hieun03/USB_CAN_Transceiver_Board/EasyEDA/3D_PCB_Bottom_View_2026-08-12.png

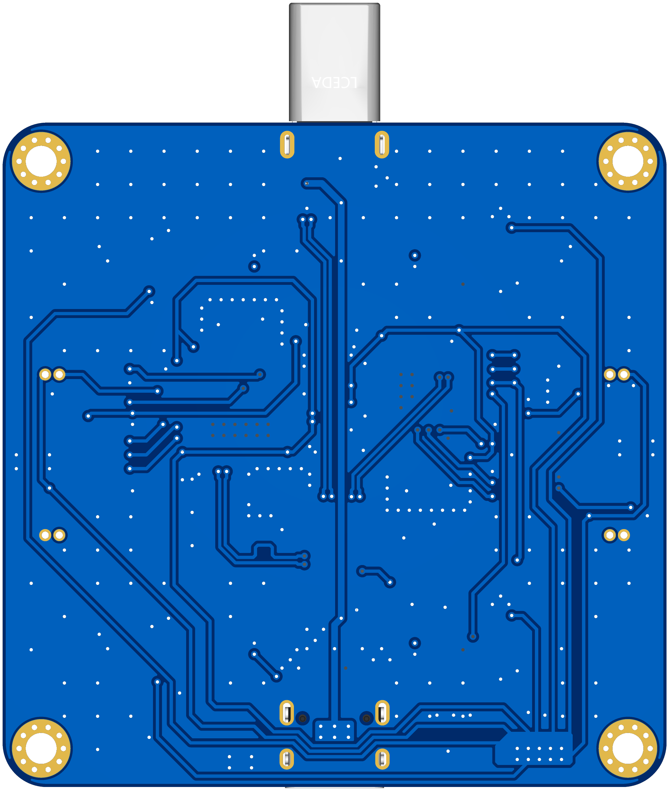
EasyEDA/3D_PCB_Bottom_View_2026-08-12.png
