hieun03/USB_CAN_Transceiver_Board/docs/CAN_FD_Adapter_Circuit_Schematic.xlsx

Sheet: MCU Pinout
CAN FD Adapter — MCU Pinout (STM32G474, single-channel / single USB port design)
Note: For the 2x USB + USB Hub architecture, this pin list applies to EACH MCU board separately (2 boards total).
Pin | Function | Connection | Alternate Function / Setting | Category | Note
PA11 | USB_DM | Hub downstream port D- | AF14 | USB | Internal USB FS PHY, no external IC needed
PA12 | USB_DP | Hub downstream port D+ | AF14 | USB | Internal USB FS PHY, no external IC needed
PB5 | FDCAN2_RX | CAN transceiver RXD | AF, Very High Speed | CAN | Single-channel use: FDCAN2 is sufficient
PB6 | FDCAN2_TX | CAN transceiver TXD | AF, Very High Speed | CAN | Single-channel use: FDCAN2 is sufficient
PB3 | FDCAN3_RX | CAN transceiver RXD (2nd channel) | AF, Very High Speed | CAN | Only if 2 channels are needed on the same MCU
PB4 | FDCAN3_TX | CAN transceiver TXD (2nd channel) | AF, Very High Speed | CAN | Only if 2 channels are needed on the same MCU
PH0 (OSC_IN) | HSE Input | 24 MHz crystal | - | Clock | External oscillator input
PH1 (OSC_OUT) | HSE Output | 24 MHz crystal | - | Clock | External oscillator output
NRST | Reset | Reset button + 100nF capacitor | - | Power/Reset | Standard reset circuit
BOOT0 | Boot Select | Pull-down 10kΩ | - | Boot | Optional jumper for entering DFU mode
SWDIO | Debug Data | Programming header | - | Debug | 4-pin header: SWDIO, SWCLK, GND, VDD
SWCLK | Debug Clock | Programming header | - | Debug | 4-pin header: SWDIO, SWCLK, GND, VDD
VDD (x4-6 pins) | Digital Power | 3.3V | - | Power | 100nF decoupling capacitor on each VDD pin
VSS (x4-6 pins) | Digital Ground | GND | - | Power | -
VDDA | Analog Power | 3.3V (filtered via ferrite bead) | - | Power | Clean power supply for ADC/PLL
VSSA | Analog Ground | GND | - | Power | -
VBAT | Backup Power | Can be bridged to 3.3V | - | Power | Bridge to VDD if RTC is not used

Sheet: CAN Transceiver IC
CAN Transceiver IC Options (one required per CAN channel)
Green row: recommended choice (cost/performance balance)
IC | Manufacturer | CAN FD Support | Max Speed | Approx. Unit Price (USD) | Package / Note
TCAN1042HGVDRQ1 | Texas Instruments | Yes | 5 Mbps | $1.20 - $1.80 | SOIC-8, automotive grade, widely used
TCAN1044VDRQ1 | Texas Instruments | Yes | 5 Mbps | $1.00 - $1.50 | SOIC-8, has standby mode, economical
MCP2562FD | Microchip | Yes | 8 Mbps | $1.00 - $1.40 | SOIC-8 / DFN, good price/performance
SN65HVD230 | Texas Instruments | No (classic CAN) | 1 Mbps | $0.60 - $0.90 | SOIC-8, does NOT support FD - DO NOT USE
ISO1042 | Texas Instruments | Yes | 5 Mbps | $3.00 - $4.50 | SOIC-8/16, galvanic isolation, for industrial environments
Note: Prices are estimates and vary by distributor (Mouser/DigiKey/LCSC) and quantity. Please verify current pricing.

Sheet: USB Hub IC
USB Hub IC Options (to combine 2 MCU boards into a single USB connector)
Architecture: PC <--USB--> [Hub IC] <--> 2x Downstream Port <--> 2x MCU Board (each manages its own CAN channel)
Green row: recommended choice
IC | Manufacturer | Port Count | Speed | Approx. Unit Price (USD) | Package / Note
FE1.1s | Terminus Technology | 4 ports | USB 2.0 HS/FS | $0.30 - $0.50 | SSOP-28, cheapest, no external EEPROM needed
GL850G | Genesys Logic | 4 ports | USB 2.0 HS/FS | $0.50 - $0.80 | SSOP-28, stable, widely used
USB2513B | Microchip | 3 ports | USB 2.0 HS/FS | $1.50 - $2.20 | QFN-36, industrial grade, SMBus config option
USB2517 | Microchip | 7 ports | USB 2.0 HS/FS | $2.00 - $3.00 | QFN-48, extra port capacity, good support
TUSB2077A | Texas Instruments | 7 ports | USB 2.0 FS | $1.50 - $2.00 | QFP-48, older but proven design

Sheet: Hub Additional Parts
Additional Components Required for the USB Hub IC
Component | Function | Qty | Note
12 MHz Crystal | Hub clock source | 1 | Required by most hub ICs (FE1.1s / GL850G)
Upstream Port (USB-B/USB-C) | Host (PC) connection | 1 | Single connector, facing the PC
Downstream Port | Connection to MCU boards | 2 | Panel-mount connector or board-to-board
USBLC6-2SC6 | ESD protection | 3 | Separate one for upstream + each downstream port
Self/Bus-powered strap resistor | Power mode selection | 1 | Set via a pull-up/pull-down resistor
3.3V/5V Regulator | Power for hub + MCUs | 1 | Hub typically needs 3.3V, stepped down from 5V USB VBUS

Sheet: Summary & Architecture
Project Summary: 2x USB + 1x USB Hub Architecture
Architecture Diagram (text form):
PC
│
│ USB (Upstream)
▼
[USB Hub IC: FE1.1s / GL850G]
│ │
│ Downstream 1 │ Downstream 2
▼ ▼
[MCU Board 1: STM32G474] [MCU Board 2: STM32G474]
│ │
▼ ▼
[CAN Transceiver 1] [CAN Transceiver 2]
│ │
▼ ▼
CAN Bus 1 (can0) CAN Bus 2 (can1)
Main Component List:
Component | Qty | Recommended Model | Approx. Unit Price (USD) | Total (USD) | Note
MCU (STM32G474) | 2 | STM32G474xx | $3.50 - $5.00 | $7.00 - $10.00 | 1 per board
CAN Transceiver | 2 | MCP2562FD / TCAN1044V | $1.00 - $1.50 | $2.00 - $3.00 | 1 per MCU board
USB Hub IC | 1 | FE1.1s / GL850G | $0.30 - $0.80 | $0.30 - $0.80 | Single hub, 2 of 4 ports used
24 MHz Crystal (MCU) | 2 | - | $0.10 - $0.20 | $0.20 - $0.40 | 1 per MCU
12 MHz Crystal (Hub) | 1 | - | $0.10 - $0.15 | $0.10 - $0.15 | For the hub
ESD Protection (USBLC6-2SC6) | 3+ | - | $0.10 - $0.20 | $0.30 - $0.60 | Upstream + 2 downstream
Regulator (3.3V/5V) | 1-3 | - | $0.30 - $0.60 | $0.30 - $1.80 | Centralized or per-board
ESTIMATED TOTAL COST (ICs and passive components listed only, excluding PCB/connectors/enclosure): |  |  |  | ≈ $10.20 - $16.75
