hieun03/USB_CAN_Transceiver_Board/EasyEDA/SCH_Schematic_2026-08-12.pdf

Schematic | Schematic | Create at | 2026-07-25
Update at | 2026-08-11
Board | Board_1_0 | Page | Version
Drawn | Hieu N. | USB_CAN_Transceiver_Board
Reviewed | Yigitler A.
Version | Size | Page 1 Total 8
V0.0 | A4 | VNX Robotics
Date | Version Number | Details
July 25th 2026 | V1.0 | Finished on August 11th 2026

# 2 x CAN Transceiver

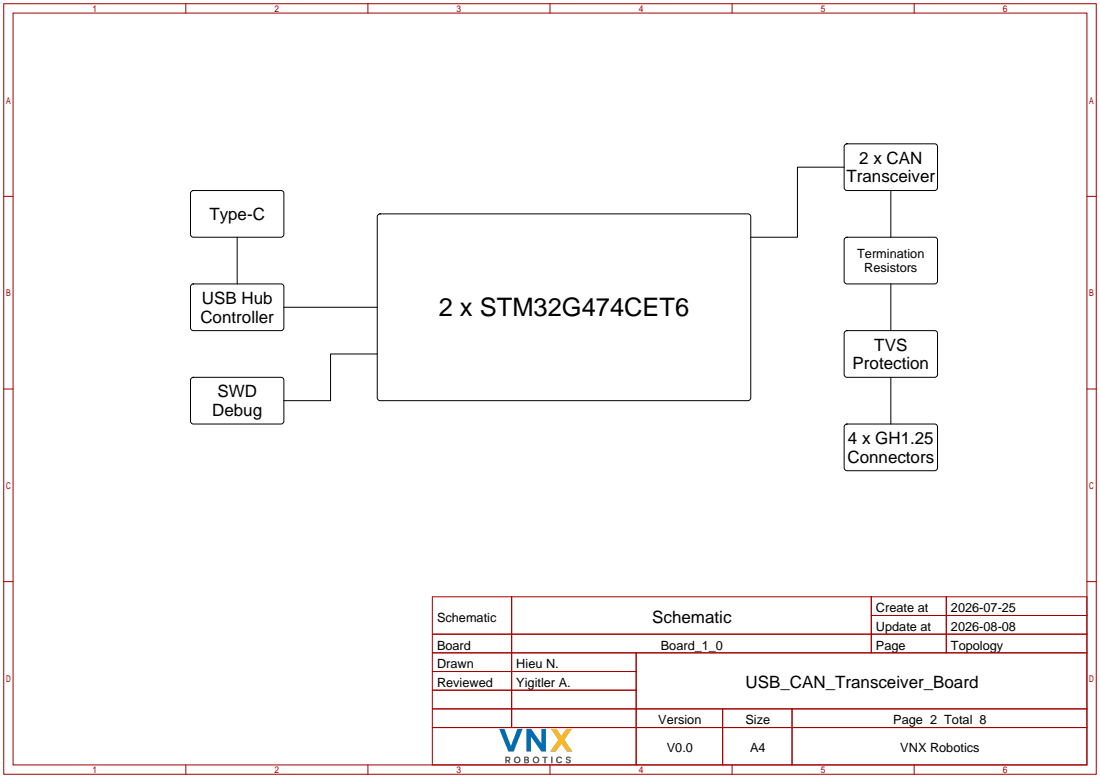
[picture p3: page 2]

Schematic | Schematic | Create at | 2026-07-25

Update at | 2026-08-08

Board | Board_1_0 | Page | Topology
Drawn | Hieu N. | USB_CAN_Transceiver_Board
Reviewed | Yigitler A.

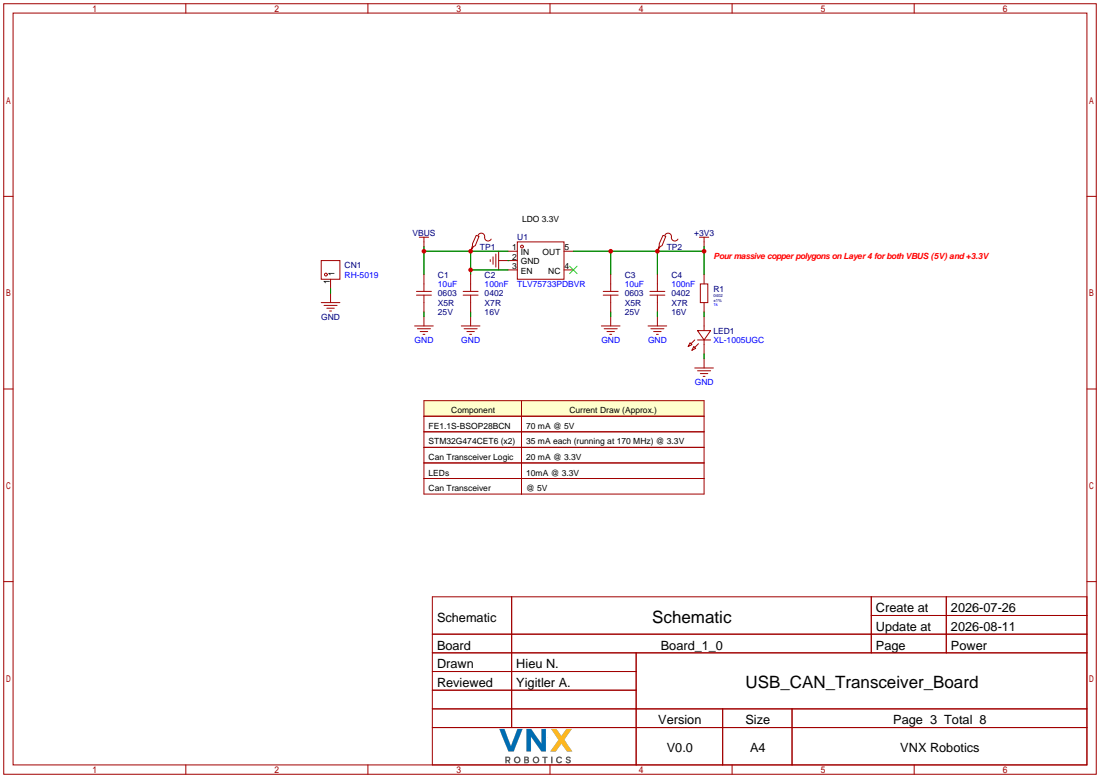
[picture p4: page 3]

Pour massive copper polygons on Layer 4 for both VBUS (5V) and +3.3V

Component | Current Draw (Approx.)
FE1.1S-BSOP28BCN | 70 mA @ 5V
STM32G474CET6 (x2) | 35 mA each (running at 170 MHz) @ 3.3V
Can Transceiver Logic | 20 mA @ 3.3V
LEDs | 10mA @ 3.3V
Can Transceiver | @ 5V

Schematic | Schematic | Create at | 2026-07-26

Update at | 2026-08-11

Board | Board_1_0 | Page | Power
Drawn | Hieu N. | USB_CAN_Transceiver_Board
Reviewed | Yigitler A.

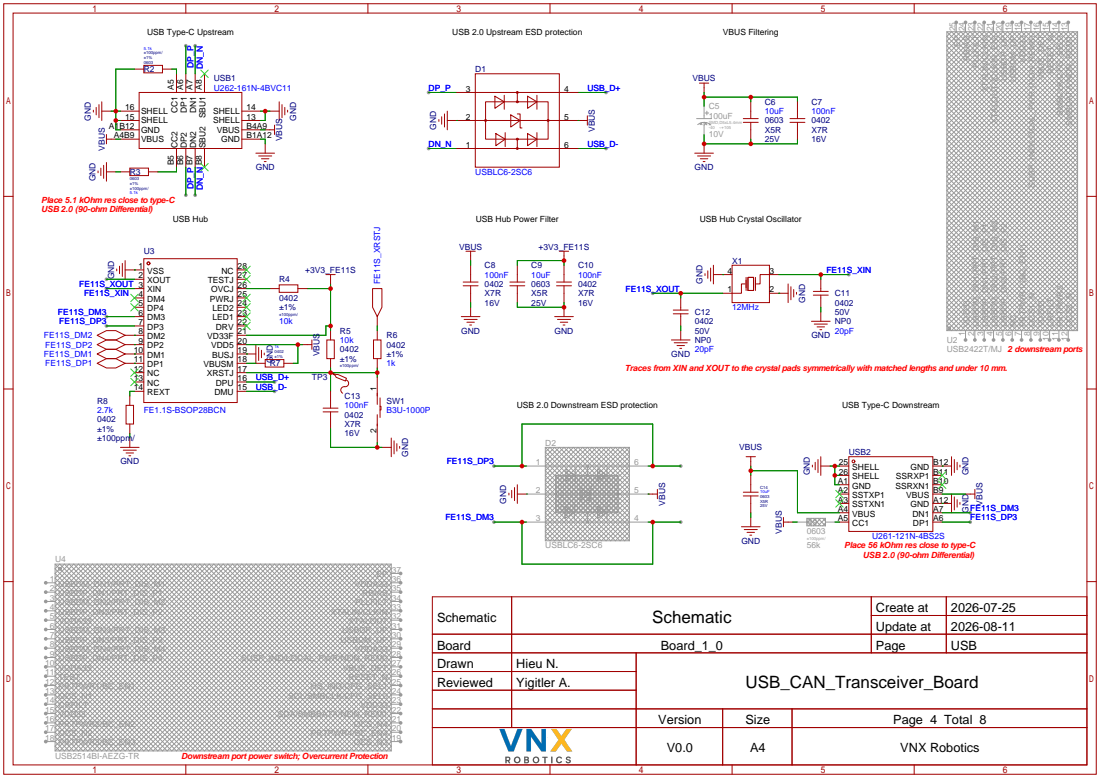
[picture p5: page 4]

USB 2.0 Upstream ESD protection

Place 5.1 kOhm res close to type-C
USB 2.0 (90-ohm Differential)

USB Hub Power Filter

USB Hub Crystal Oscillator

Traces from XIN and XOUT to the crystal pads symmetrically with matched lengths and under 10 mm.

USB 2.0 Downstream ESD protection

Place 56 kOhm res close to type-C

Schematic | Schematic | Create at | 2026-07-25

Update at | 2026-08-11

Board | Board_1_0 | Page | USB
Drawn | Hieu N. | USB_CAN_Transceiver_Board
Reviewed | Yigitler A.

Downstream port power switch; Overcurrent Protection

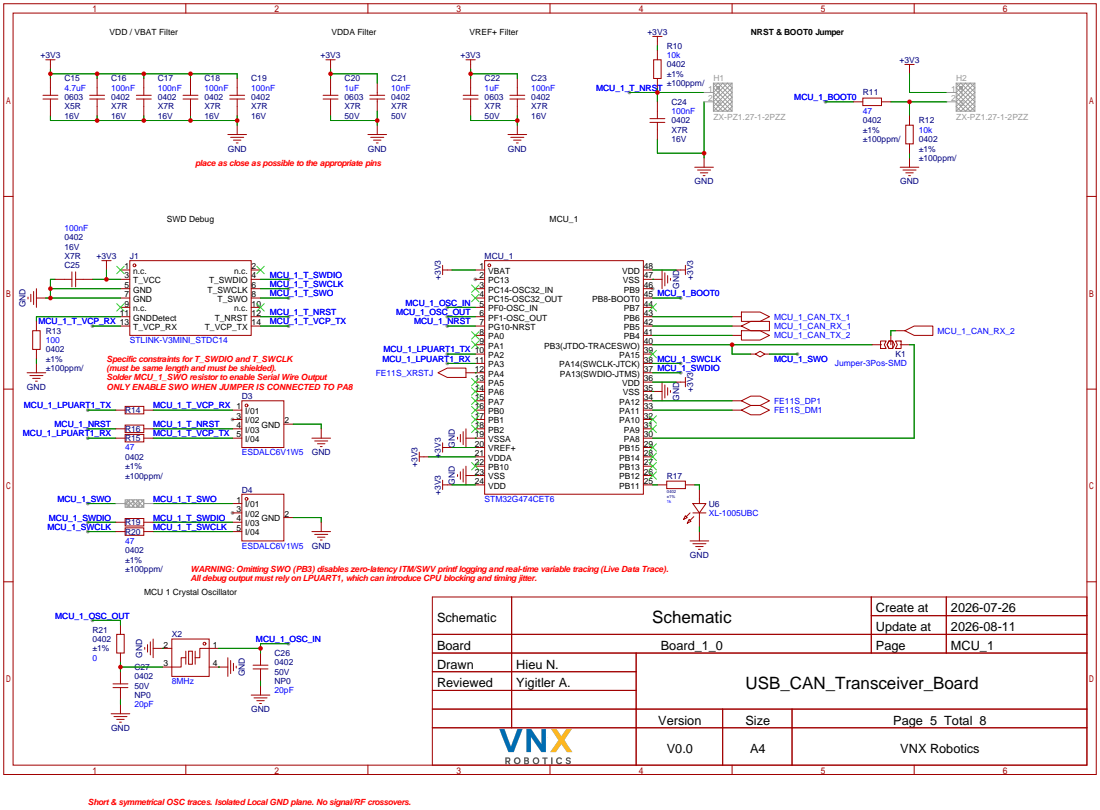
[picture p6: page 5]

GND
place as close as possible to the appropriate pins

T_VCC 3
GND 5
10 GND 7
GNDDetect 11
T_VCP_RX 13
STLINK-V3MINI_STDC14
Specific constraints for T_SWDIO and T_SWCLK
(must be same length and must be shielded).
Solder MCU_1_SWO resistor to enable Serial Wire Output
ONLY ENABLE SWO WHEN JUMPER IS CONNECTED TO PA8

WARNING: Omitting SWO (PB3) disables zero-latency ITM/SWV printf logging and real-time variable tracing (Live Data Trace).
All debug output must rely on LPUART1, which can introduce CPU blocking and timing jitter.

Schematic | Schematic | Create at | 2026-07-26

Update at | 2026-08-11

Board | Board_1_0 | Page | MCU_1
Drawn | Hieu N. | USB_CAN_Transceiver_Board
Reviewed | Yigitler A.

Short & symmetrical OSC traces. Isolated Local GND plane. No signal/RF crossovers.

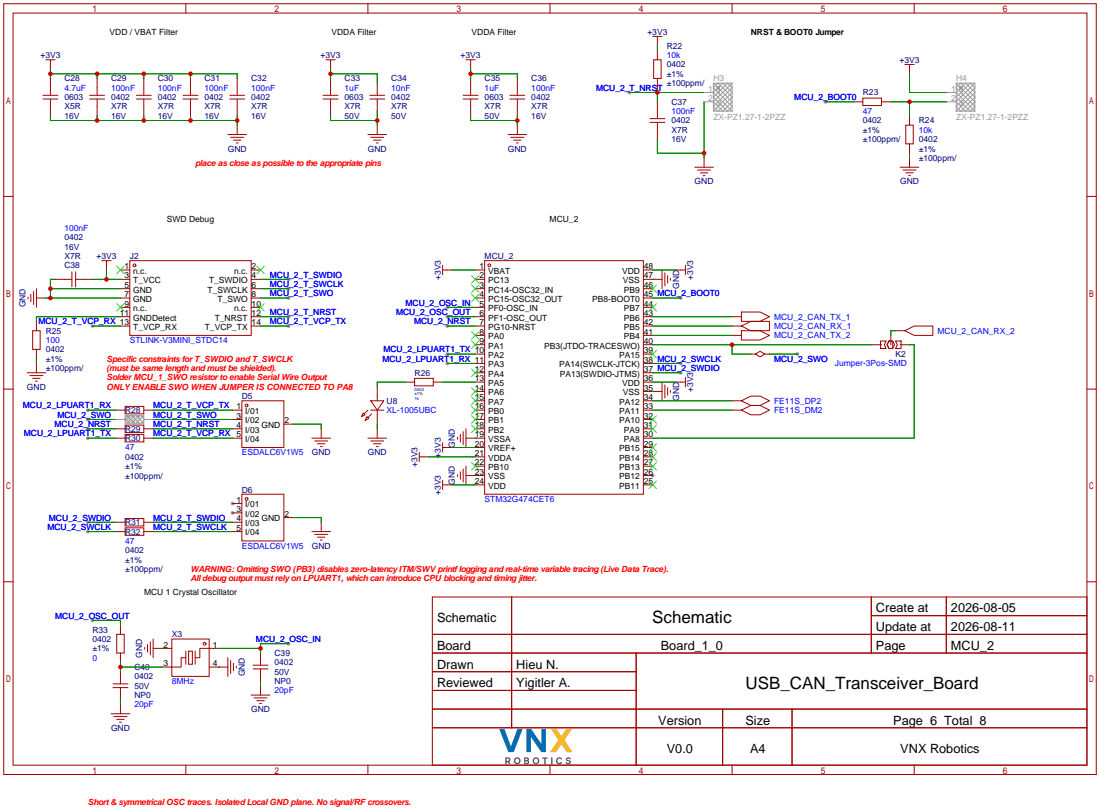
[picture p7: page 6]

GND
place as close as possible to the appropriate pins

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

Schematic | Schematic | Create at | 2026-08-05

Update at | 2026-08-11

Board | Board_1_0 | Page | MCU_2
Drawn | Hieu N. | USB_CAN_Transceiver_Board
Reviewed | Yigitler A.

Short & symmetrical OSC traces. Isolated Local GND plane. No signal/RF crossovers.

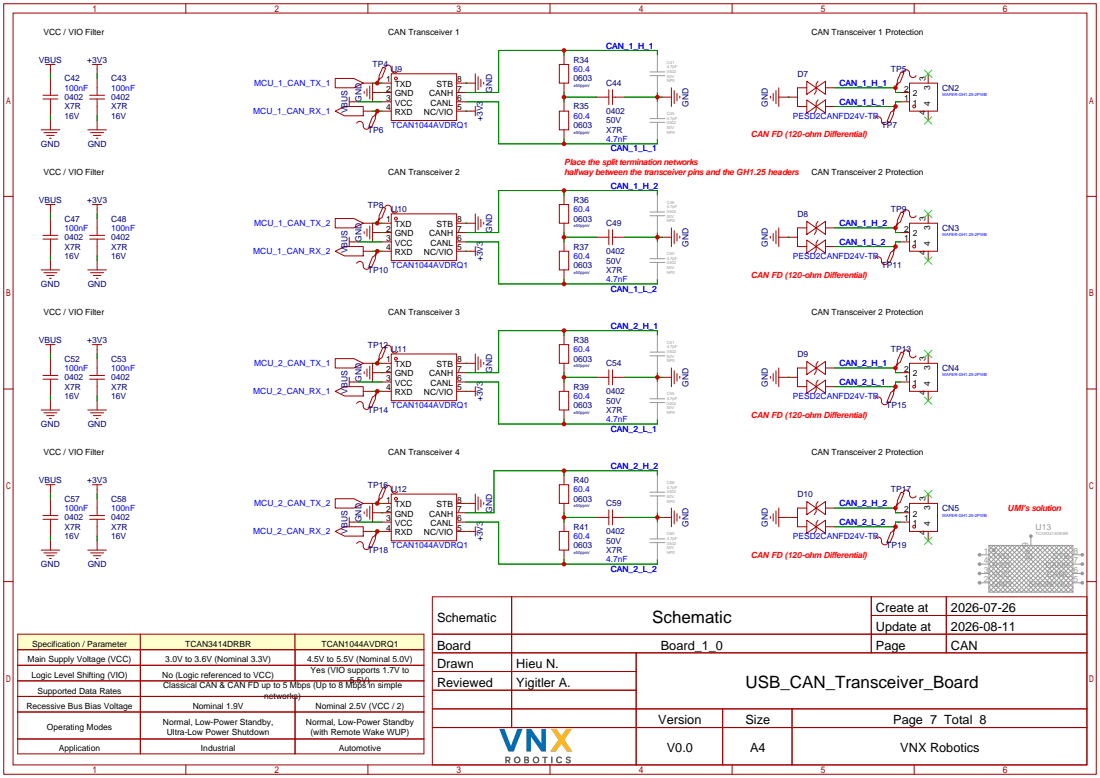
[picture p8: page 7]

CAN FD (120-ohm Differential)

Place the split termination networks

Schematic | Schematic | Create at | 2026-07-26

Update at | 2026-08-11

Logic Level Shifting (VIO) | No (Logic referenced to VCC) | Yes (VIO supports 1.7V to
Supported Data Rates | Classical CAN & CAN FD up to 5 Mbps (Up to 8 Mbps in simple networks)
Recessive Bus Bias Voltage | Nominal 1.9V | Nominal 2.5V (VCC / 2)
Operating Modes | Normal, Low-Power Standby, Ultra-Low Power Shutdown | Normal, Low-Power Standby (with Remote Wake WUP)

Version | Size | Page 7 Total 8

Application | Industrial | Automotive

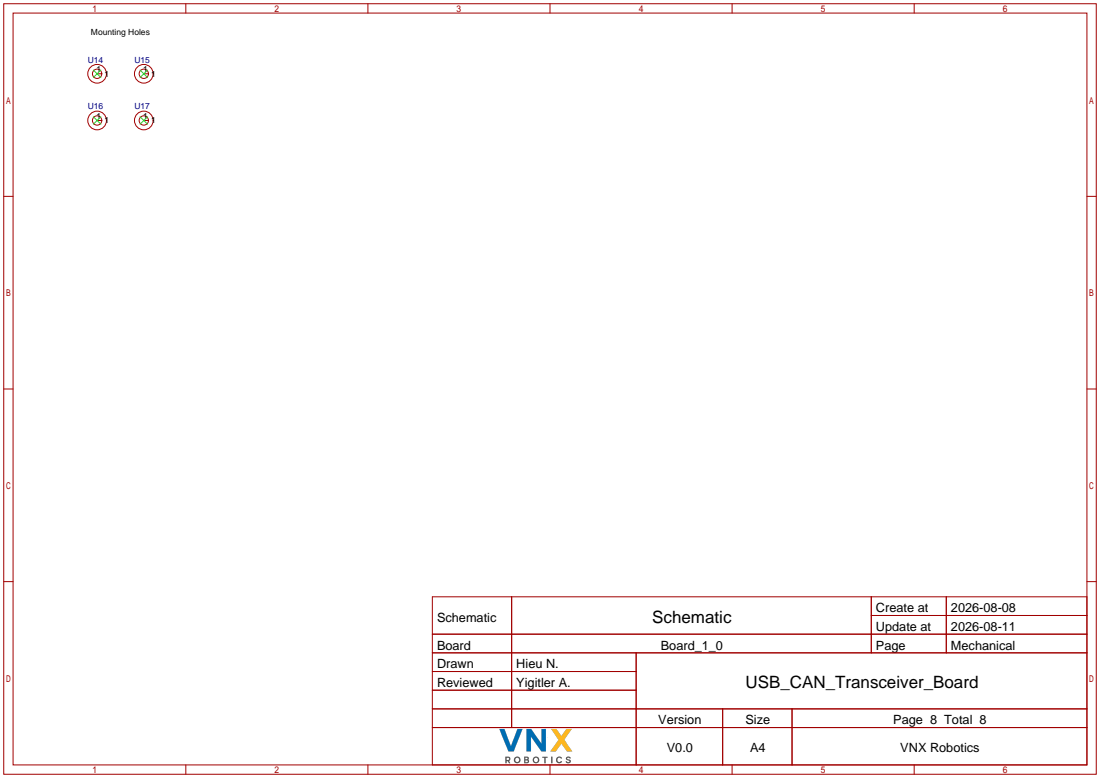
[picture p9: page 8]

Schematic | Schematic | Create at | 2026-08-08

Update at | 2026-08-11

Board | Board_1_0 | Page | Mechanical
Drawn | Hieu N. | USB_CAN_Transceiver_Board
Reviewed | Yigitler A.
