hieun03/USB_CAN_Transceiver_Board/EasyEDA/PCB_PCB_2026-08-12.pdf

# USB2

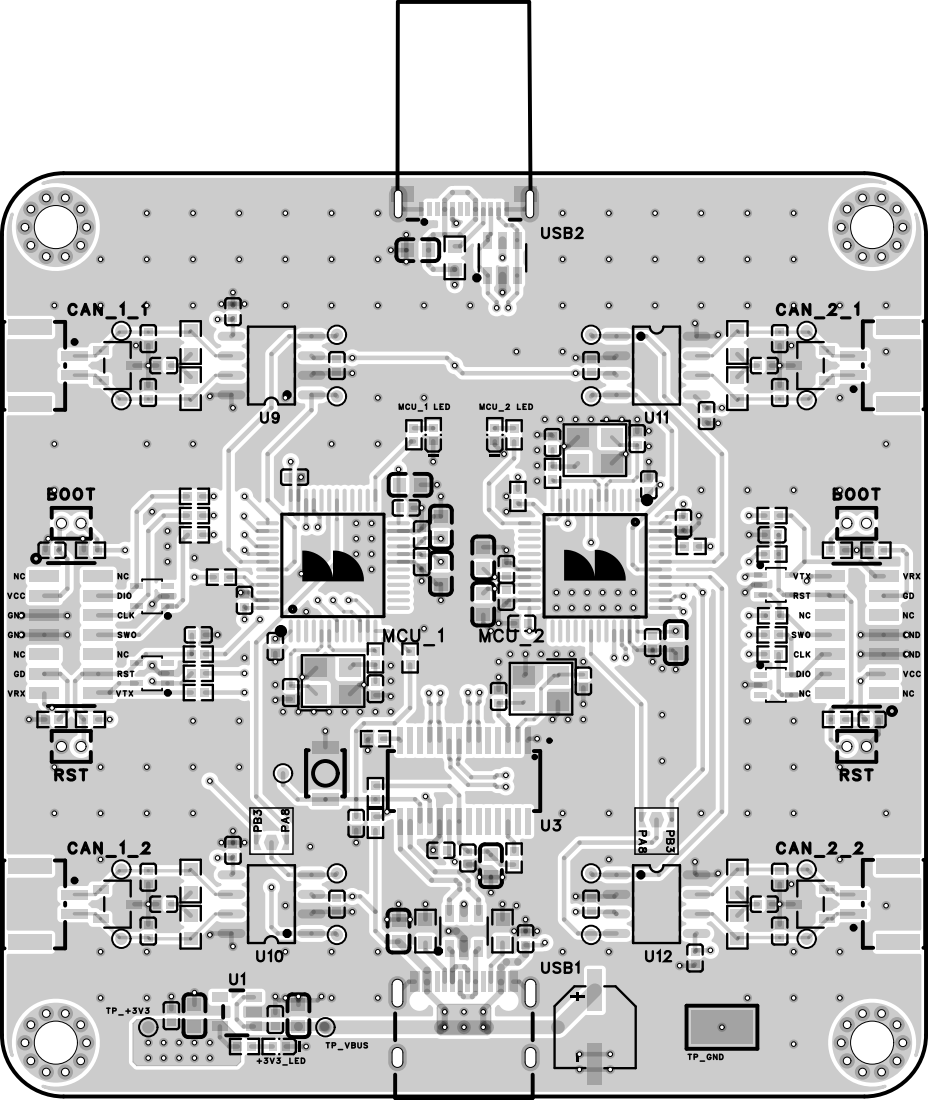
[picture p16: page 1]

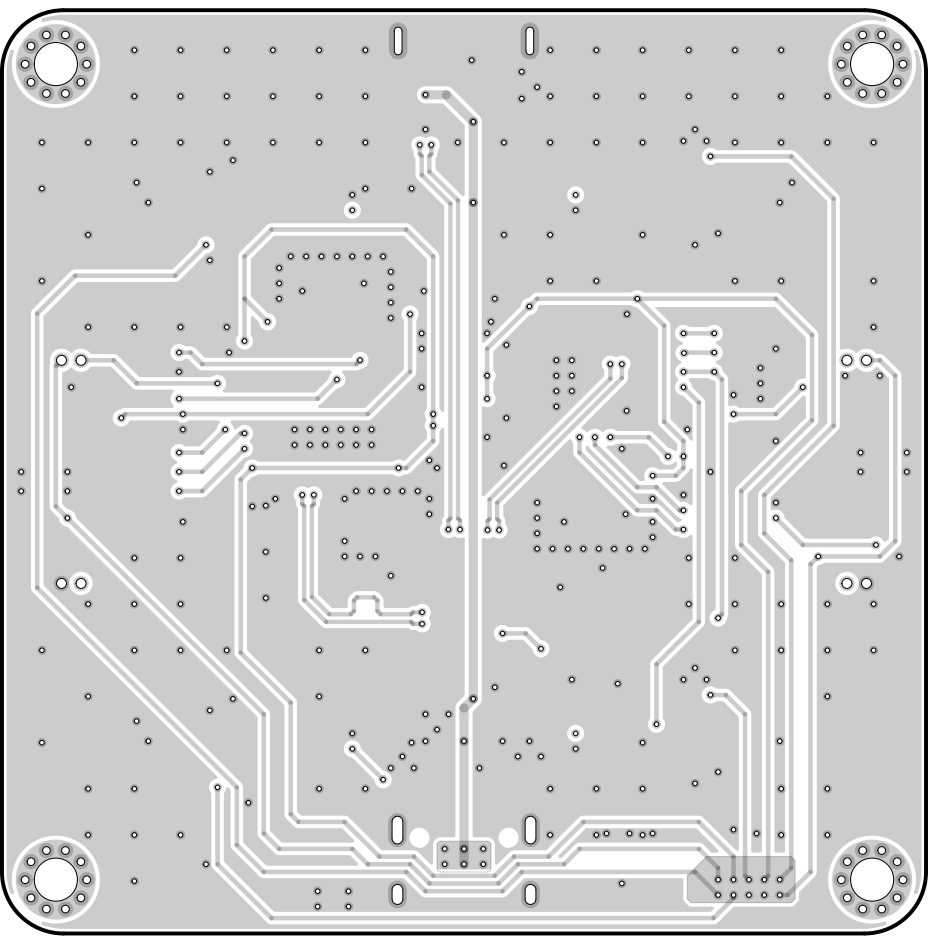
[picture p17: page 2]

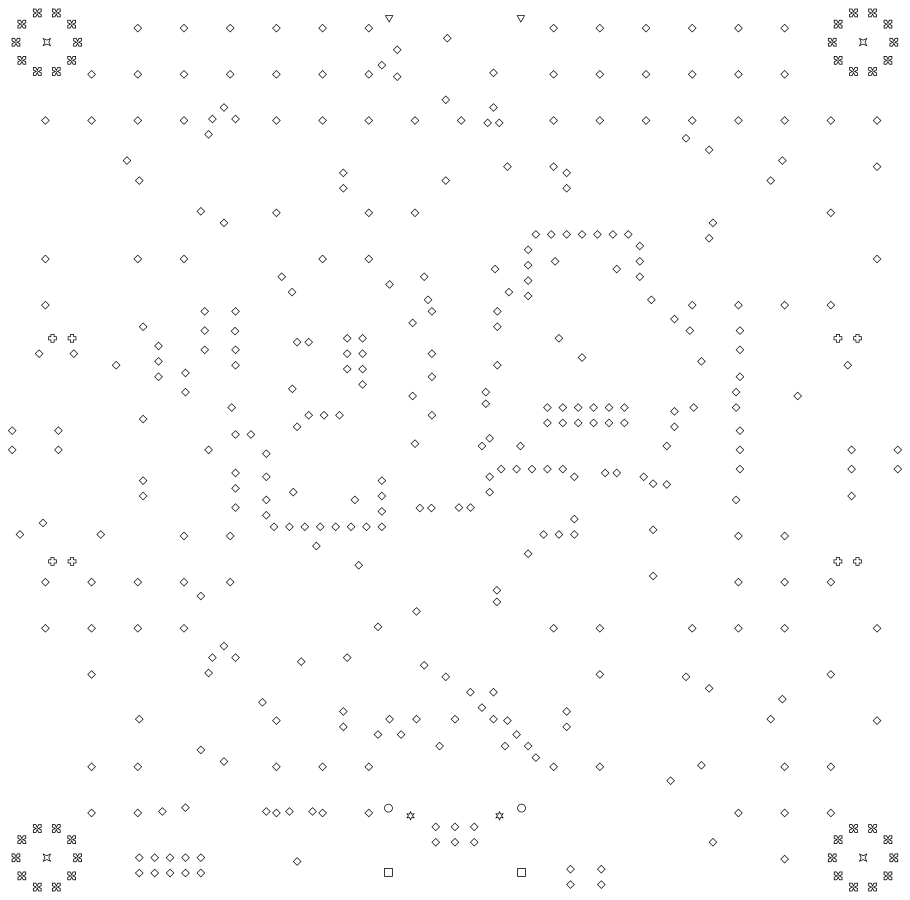
[picture p18: page 3]
