hieun03/USB_CAN_Transceiver_Board/docs/XKB Connection U262-161N-4BVC11.pdf

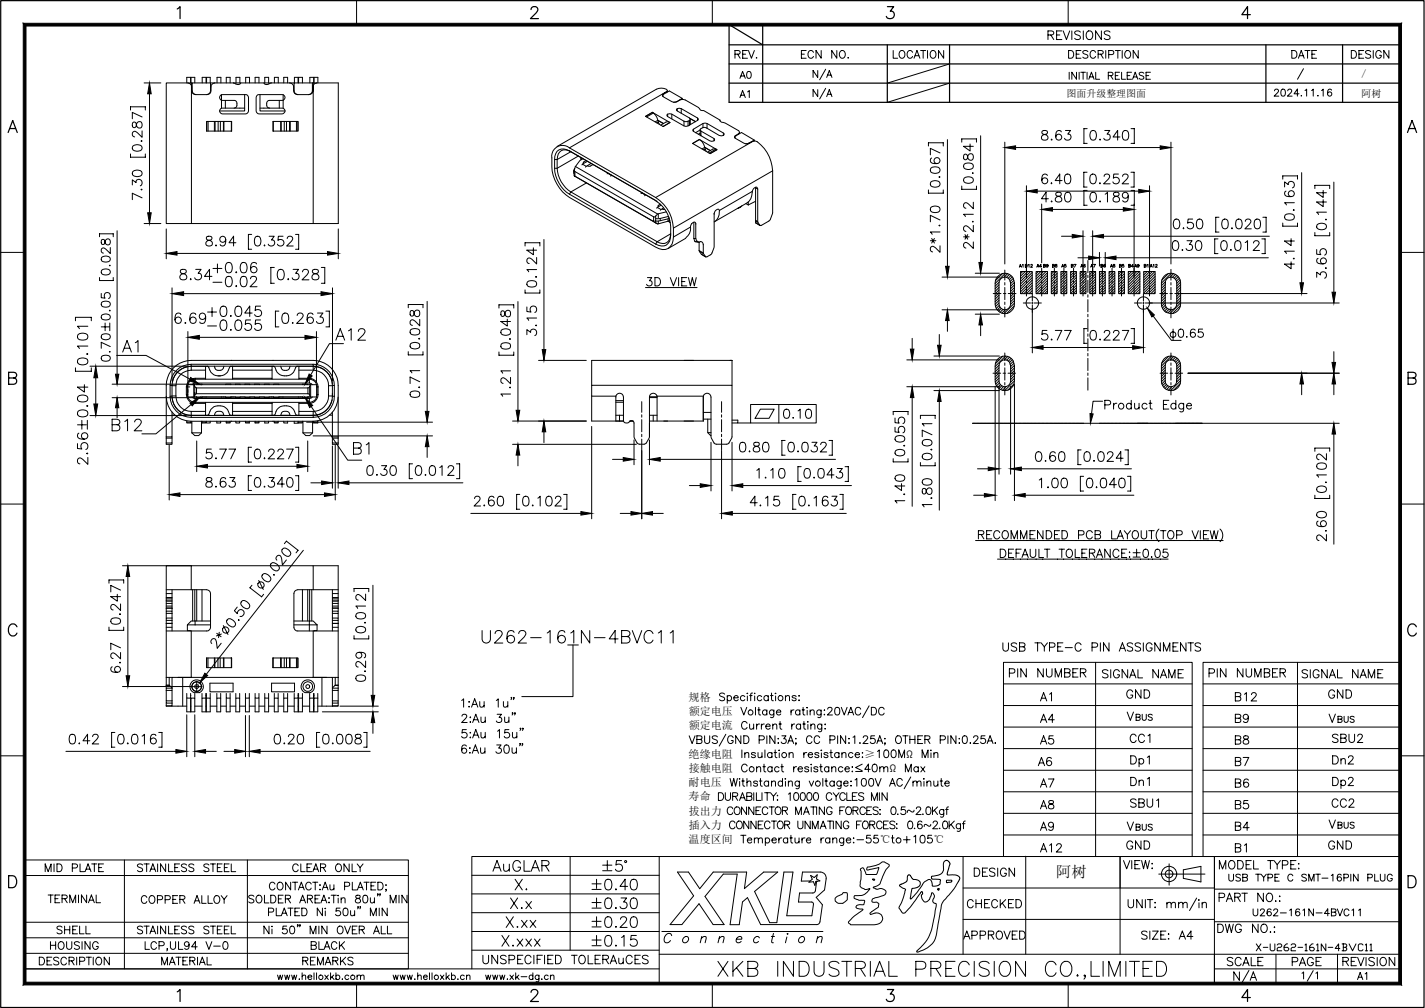
[picture p19: page 1]
规格 额定电压 额定电流; 绝缘电阻; 接触电阻; 耐电压 寿命 拔出力 插入力; 温度区间; 图面升级整理图面
