hieun03/USB_CAN_Transceiver_Board/(list of files, drawings)

Other design files:
EasyEDA/ProPrj_USB_CAN_Transceiver_Board_2026-08-12.epro
Main.SchDoc
Topology.SchDoc
USB_CAN_Transceiver_Board.PrjPcb
