hieun03/USB_CAN_Transceiver_Board/(commit log)

2026-07-26 feat: init project
    [CAN_FD_Adapter_Circuit_Schematic.xlsx, Main.SchDoc, Topology.SchDoc, USB_CAN_Transceiver_Board.PrjPcb]
2026-08-11 feat: completed
    [ProPrj_USB_CAN_Transceiver_Board_2026-08-12.epro]
